sababa27/8-Bit-Computer/README.md

# 8-Bit-Computer
8-Bit Computer for our Junior Project, based on Ben Eater's "Build an 8-bit computer from scratch"

My 8-bit computer
