sababa27/8-Bit-Computer/(list of files, cad)

Other CAD files:
PCB/Display/Display_DXF_AutoCAD2007.f3d
