sababa27/8-Bit-Computer/Logisim/RAM/Usage.rtf

g++-15 ram.cpp -o ram

./ram inputPath outputPath
