sababa27/8-Bit-Computer/(list of files, drawings)

Other design files:
Logisim/comp.circ
PCB/AB_Register/AB_Register.eprj
PCB/ALU/ALU.eprj
PCB/Clock/Clock.eprj
PCB/Control_Logic/Control_Logic.eprj
PCB/Display/Display.eprj
PCB/Flags_Register/Flags_Register.eprj
PCB/Instruction_Register/Instruction_Register.eprj
PCB/MAR/MAR.eprj
PCB/MAR_v0/MAR.eprj
PCB/Output_Register/Output_Register.eprj
PCB/Program_Counter/Program_Counter.eprj
PCB/RAM/RAM.eprj
PCB/RAM_v0/RAM.eprj
