sababa27/8-Bit-Computer/(commit log)

2025-07-22 Large part of the project has been implemented virtually. commands file contains 7 assembly instructions.
    [comp.circ]
2025-07-22 added 3 more instructions, made parts of main file look much cleaner
    [comp.circ]
2025-07-22 added 3 digit 7 segment display for output in decimal base
    [comp.circ]
2025-07-23 Removed bitwise
    [comp.circ]
2025-07-23 added conditional jumps
    [comp.circ]
2025-07-23 made main of logisim prettier :)
    [comp.circ]
2025-08-09 started designing pcbs,designed schematics for A, B, Instructions registers, Clock and ALU
    [PCB.eprj]
2025-08-12 tekla corrected schematics of every part, I added PCB design of flag register
    [PCB.eprj, comp.circ]
2025-08-12 made PCB design for program counter
    [PCB.eprj]
2025-08-13 added control logic and output register schematics
    [PCB.eprj]
2025-08-13 added seperate files for some parts
    [AB_Register.eprj, ALU.eprj, PCB.eprj]
2025-08-13 changed name
    [AB_Register.eprj]
2025-08-14 created pcb for a register
    [AB_Register.eprj]
2025-08-14 davamate alu pcb
    [ALU.eprj]
2025-08-15 clock pcb added
    [ALU.eprj, Clock.eprj]
2025-08-15 corrected some mistakes in A/B registers and ALU pcbs
    [AB_Register.eprj, ALU.eprj]
2025-08-15 added Instruction Register PCB
    [Instruction_Register.eprj]
2025-08-16 added gerber files for 6 pcb designs
    [AB_Register.eprj, ALU.eprj, Clock.eprj, Flags_Register.eprj, Instruction_Register.eprj, PCB.eprj, Program_Counter.eprj]
2025-08-20 added output register pcb
    [Output_Register.eprj]
2025-08-20 added control logic pcb
    [Control_Logic.eprj]
2025-08-24 added schematics for memory address register
    [MAR.eprj]
2025-08-24 rearanged files
    [AB_Register.eprj, ALU.eprj, Clock.eprj, Control_Logic.eprj, Flags_Register.eprj, Instruction_Register.eprj, MAR.eprj, Output_Register.eprj]
2025-08-26 added first version schematics of RAM
    [MAR.eprj, RAM.eprj]
2025-08-26 added MAR PCB design
    [MAR.eprj]
2025-08-26 minor changes
    [Control_Logic.eprj, RAM.eprj]
2025-08-26 added RAM PCB
    [RAM.eprj]
2025-08-26 added labels on leds and components
    [Control_Logic.eprj, RAM.eprj]
2025-08-26 improved output register pcb
    [Output_Register.eprj]
2025-08-26 corrected mistakes in control logic
    [Control_Logic.eprj]
2025-08-26 corrected minor mistakes
    [RAM.eprj]
2025-08-31 added gerber files
2025-09-22 added assembly to binary code translator written in c++
    [Display.eprj]
2025-09-23 Logisim assembly translator updated
2025-10-16 added arduino IDE code for eeprom programming, for output register and control logic
    [Display.eprj, comp.circ]
2025-10-26 more logisim code, corrected docnumentation and eeprom control logic code
    [Display_DXF_AutoCAD2007.f3d]
